gazzmaniac/Agnus-Buddy/Schematic.pdf

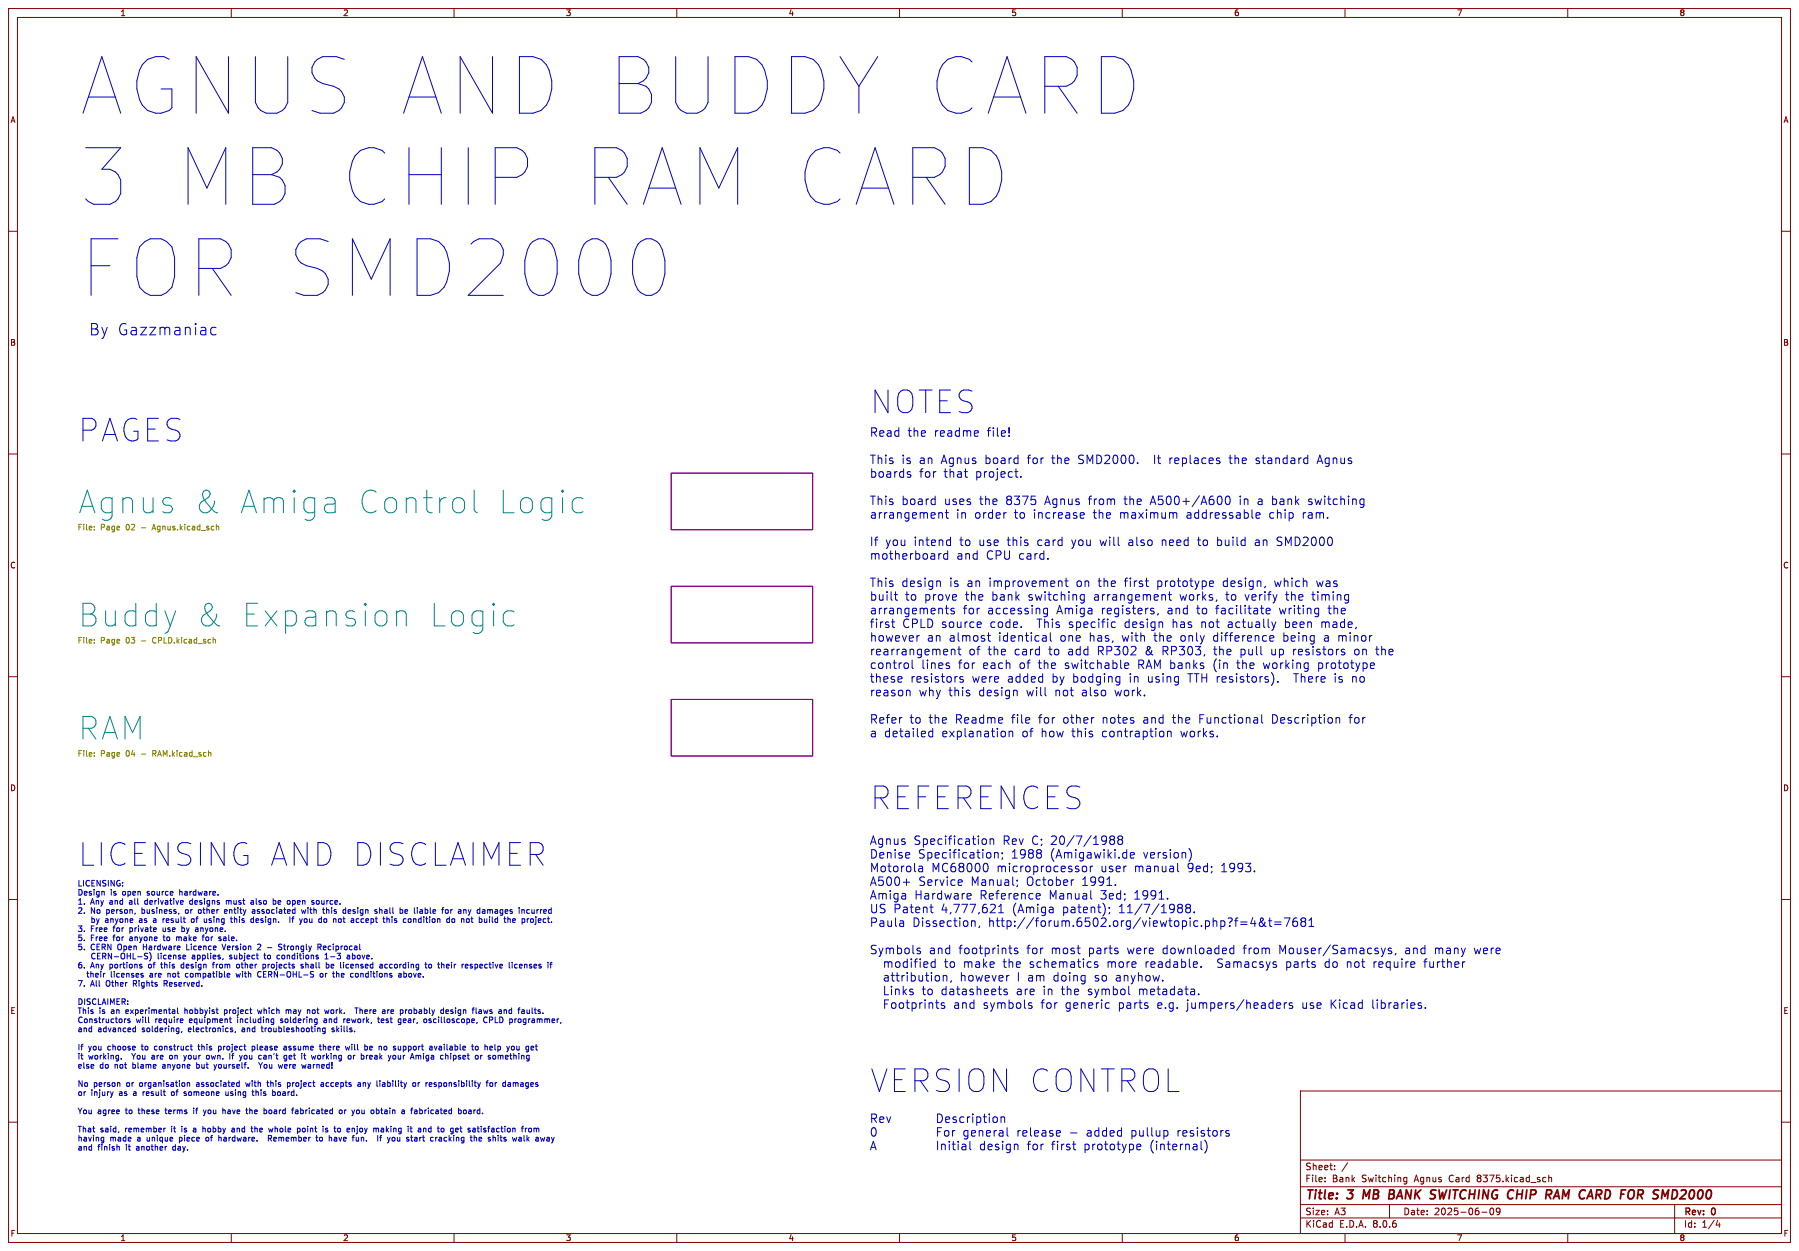
[picture p4: page 1]

AGNUS AND BUDDY CARD
FOR SMD2000

Read the readme file!

boards for that project.

If you intend to use this card you will also need to build an SMD2000

reason why this design will not also work.

Id: 1/4 Title: 3 MB BANK SWITCHING CHIP RAM CARD FOR SMD2000

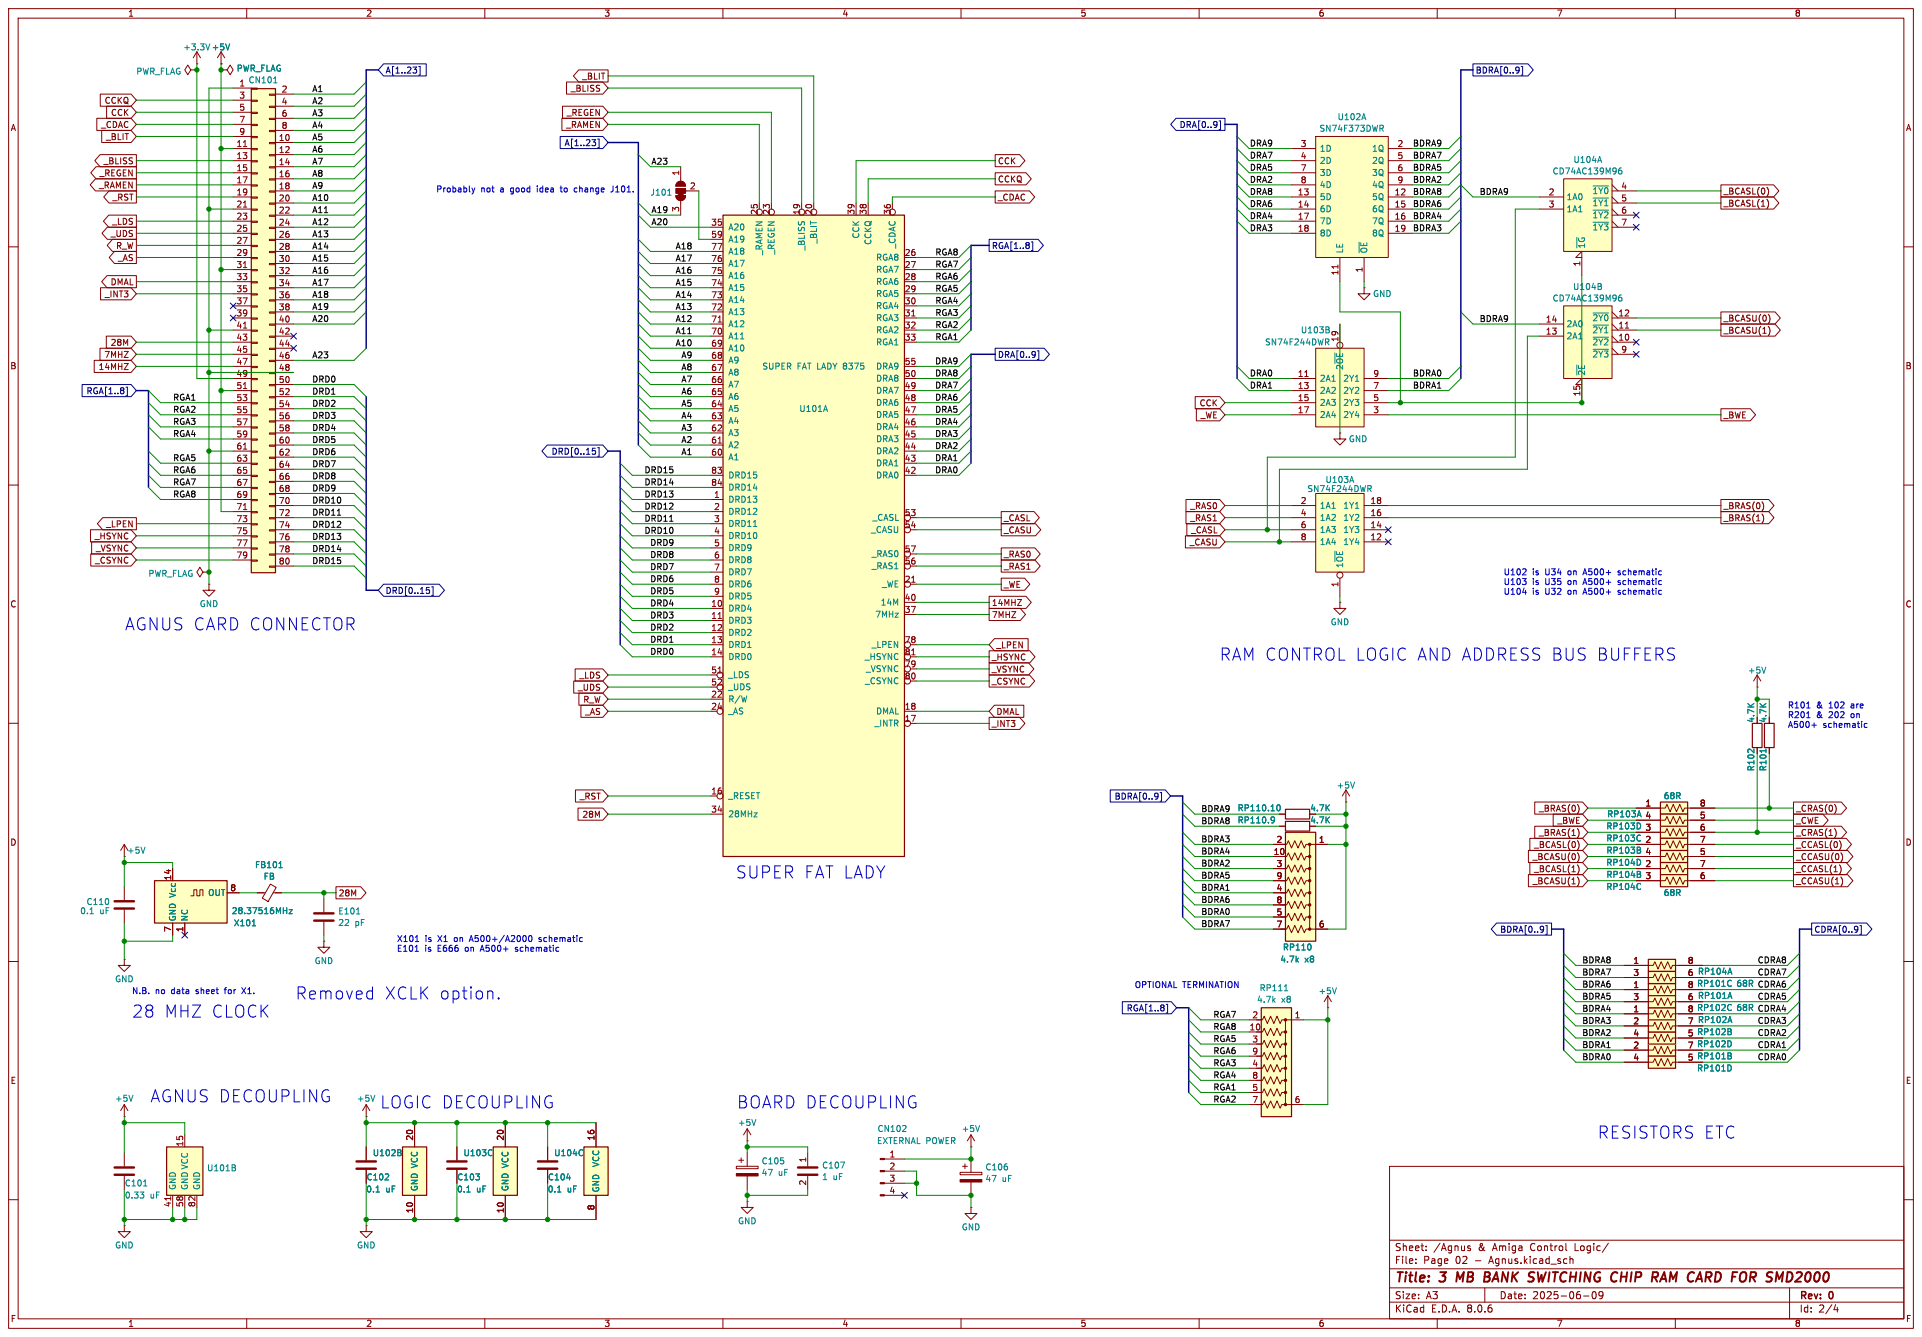
[picture p5: page 2]

U102 is U34 on A500+ schematic U103 is U35 on A500+ schematic U104 is U32 on A500+ schematic OPTIONAL TERMINATION

4 CN102 EXTERNAL POWER GND 10 VCC 20 U103C

Id: 2/4 Title: 3 MB BANK SWITCHING CHIP RAM CARD FOR SMD2000

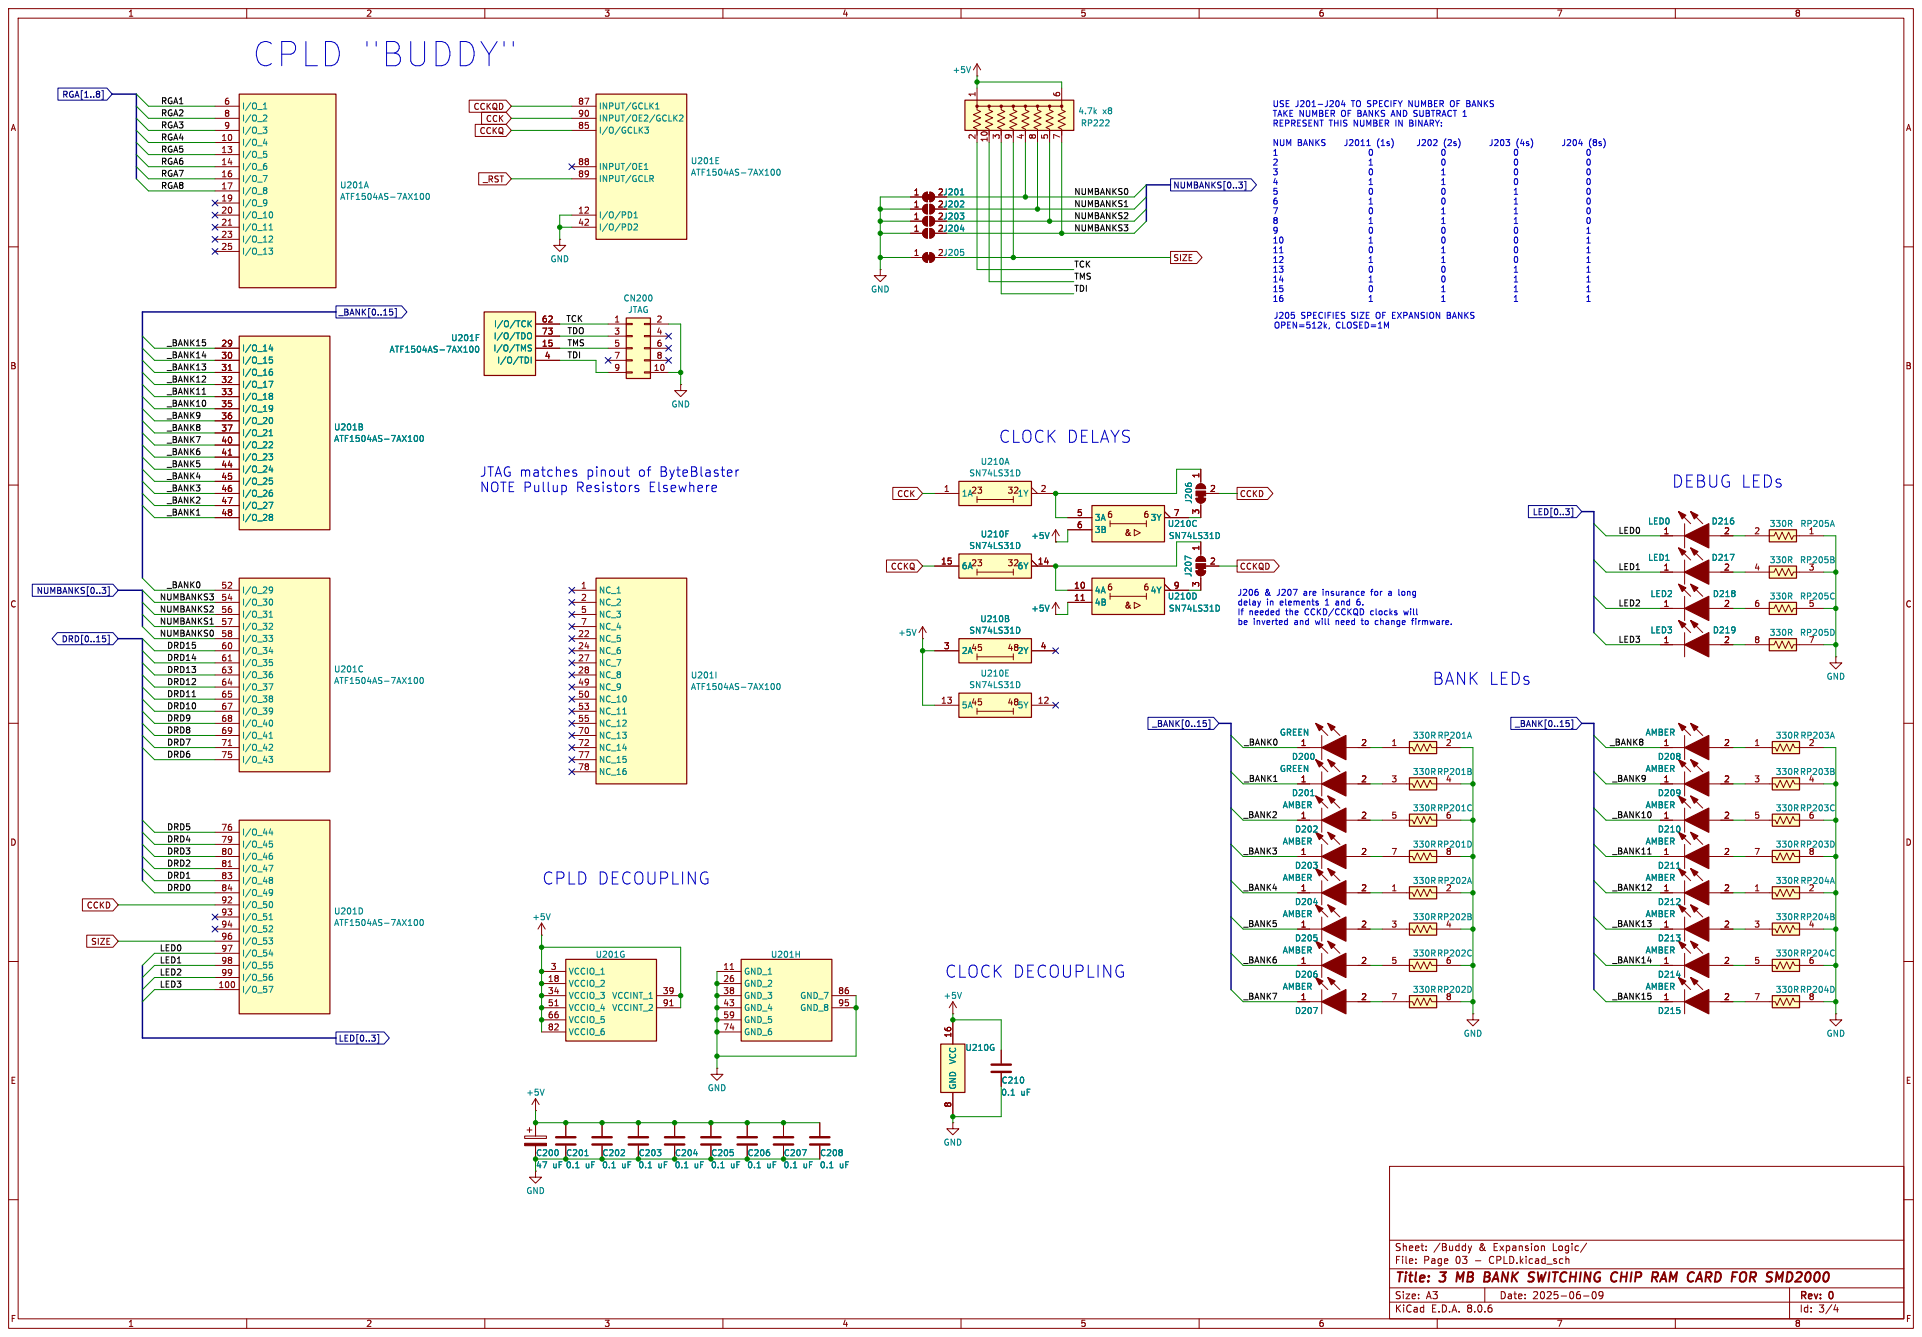
[picture p6: page 3]

JTAG matches pinout of ByteBlaster
NOTE Pullup Resistors Elsewhere

If needed the CCKD/CCKQD clocks will be inverted and will need to change firmware. CPLD DECOUPLING

Id: 3/4 Title: 3 MB BANK SWITCHING CHIP RAM CARD FOR SMD2000

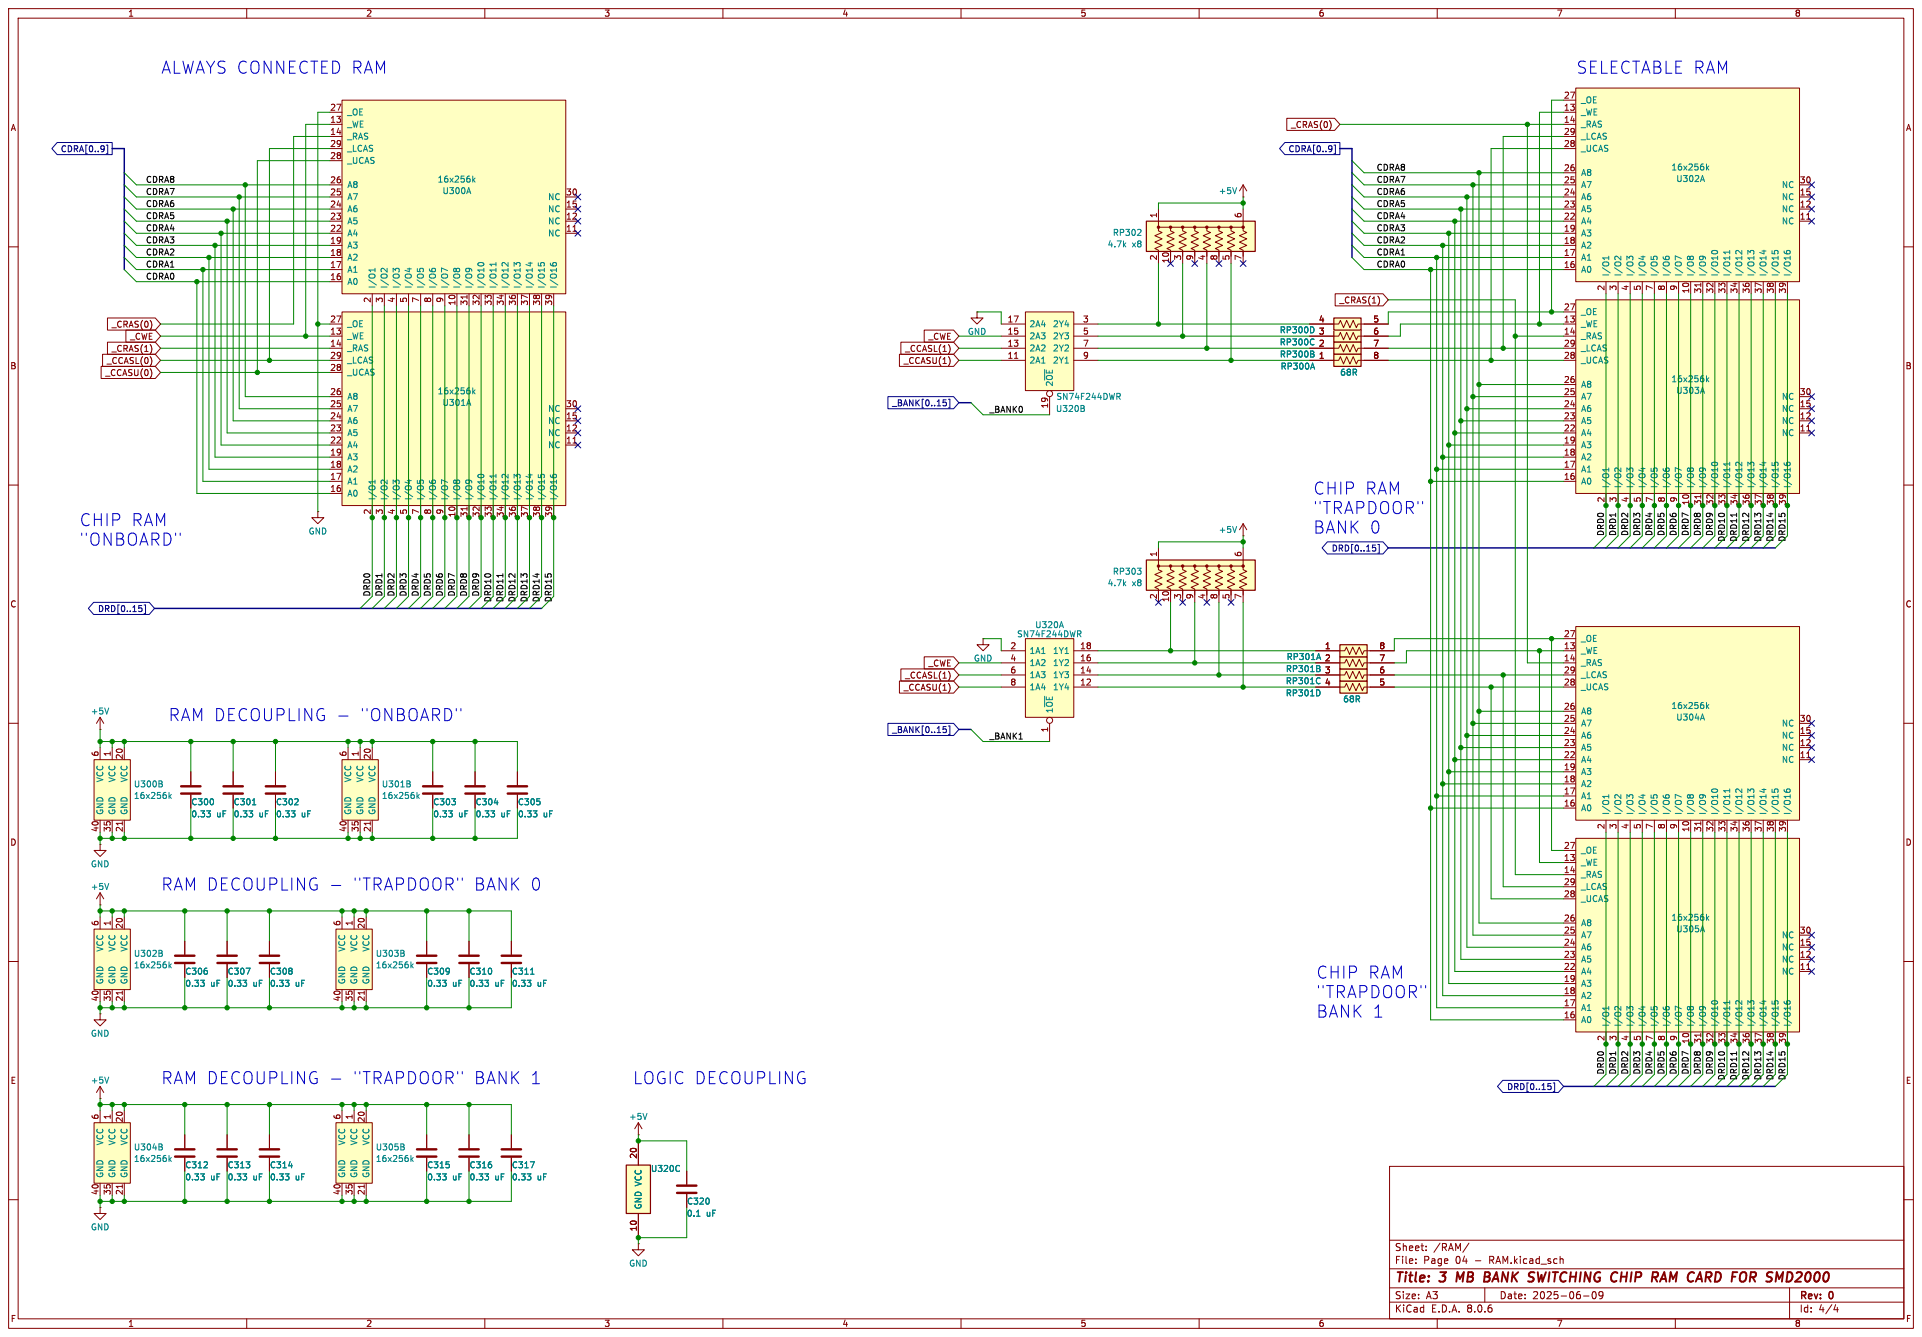
[picture p7: page 4]

RAM DECOUPLING - "TRAPDOOR" BANK 0

RAM DECOUPLING - "TRAPDOOR" BANK 1

Id: 4/4 Title: 3 MB BANK SWITCHING CHIP RAM CARD FOR SMD2000
